hexeguitar/AudioSignalGenerator/firmware/src/symbols_bmp.c

/* ### Audio Test Signal Generator #############################################
 * Copyright (c) 2017, Piotr Zapart, www.hexeguitar.com
 *
 * Caution!!!
 * Program uses modified libraries:
 * - Teensy Audio library by Paul Stoffregen
 *          - data_waveforms.c : added exponential look-up table
 *          - synth_tonesweep :
 *                              1. exponential frequency sweep
 *                              2. added sweep pause option
 *                              3. added sweep direction control
 *                              4. added sweep stop option
 *          - synth_waveform:   fixed a small bug, pulse waveform was generated
 *                              at half of the set frequency
 * - SD.h : Teensy optimization turned on
 * - Adafruit_SSD1306_t3.h - uses i2c_t3 lib in DMA mode instad of stock Wire.h
 *
 * Modified libraries are provide in the /lib directory.
 *
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
 * THE SOFTWARE IS PROVIDED "AS IS", WITHOUT WARRANTY OF ANY KIND, EXPRESS OR
 * IMPLIED, INCLUDING BUT NOT LIMITED TO THE WARRANTIES OF MERCHANTABILITY,
 * FITNESS FOR A PARTICULAR PURPOSE AND NONINFRINGEMENT. IN NO EVENT SHALL THE
 * AUTHORS OR COPYRIGHT HOLDERS BE LIABLE FOR ANY CLAIM, DAMAGES OR OTHER
 * LIABILITY, WHETHER IN AN ACTION OF CONTRACT, TORT OR OTHERWISE, ARISING FROM,
 * OUT OF OR IN CONNECTION WITH THE SOFTWARE OR THE USE OR OTHER DEALINGS IN
 * THE SOFTWARE.
 */

#include <stdint.h>

const uint8_t waveSymbols [] = {
	// 'SIN_symbol16x8'
	0x3c, 0x00, 0x42, 0x00, 0x81, 0x00, 0x81, 0x01, 0x80, 0x81, 0x00, 0x81, 0x00, 0x42, 0x00, 0x3c,

    // 'TRI_symbol16x8'
	0x08, 0x00, 0x14, 0x00, 0x22, 0x00, 0x41, 0x01, 0x80, 0x82, 0x00, 0x44, 0x00, 0x28, 0x00, 0x10,

    // 'SQR_symbol16x8'
	0xff, 0x00, 0x81, 0x00, 0x81, 0x00, 0x81, 0x02, 0x81, 0x02, 0x01, 0x02, 0x01, 0x02, 0x01, 0xfe,

    // 'PULSE_symbol16x8'
	0xf5, 0x01, 0x90, 0x01, 0x91, 0x01, 0x90, 0x01, 0x91, 0x01, 0x90, 0x01, 0x91, 0x01, 0x9f, 0xff,

	// 'R_DN_symbol16x8'
	0xc0, 0x00, 0xb0, 0x00, 0x8c, 0x00, 0x83, 0x00, 0x80, 0xc0, 0x80, 0x30, 0x80, 0x0c, 0x80, 0x03,

	// 'R_UP_symbol16x8'
	0x00, 0x03, 0x00, 0x0d, 0x00, 0x31, 0x00, 0xc1, 0x03, 0x01, 0x0c, 0x01, 0x30, 0x01, 0xc0, 0x01,
};

const uint8_t welcomeScrn [] = {
	// 'WelcomeScrn'
	0xff, 0xff, 0xff, 0xff, 0xff, 0xff, 0xff, 0xff, 0xff, 0xff, 0xff, 0xff, 0xff, 0xff, 0xff, 0xff,
	0xe0, 0x00, 0x00, 0x00, 0x00, 0x00, 0x00, 0x00, 0x00, 0x00, 0x00, 0x00, 0x00, 0x00, 0x00, 0x07,
	0xc0, 0x00, 0x00, 0x00, 0x00, 0x00, 0x00, 0x00, 0x00, 0x00, 0x00, 0x00, 0x00, 0x00, 0x00, 0x03,
	0x80, 0x00, 0x00, 0x00, 0x00, 0x00, 0x00, 0x00, 0x00, 0x00, 0x00, 0x00, 0x00, 0x00, 0x00, 0x01,
	0x80, 0x00, 0x00, 0x00, 0x00, 0x00, 0x00, 0x00, 0x00, 0x00, 0x00, 0x00, 0x00, 0x00, 0x00, 0x01,
	0x80, 0x03, 0x83, 0x06, 0x3f, 0x86, 0x0f, 0xc0, 0x1e, 0x30, 0x7e, 0x1c, 0x30, 0xe0, 0x60, 0x01,
	0x80, 0x03, 0x83, 0x06, 0x3f, 0xc6, 0x1f, 0xe0, 0x3f, 0x30, 0xff, 0x1e, 0x30, 0xe0, 0x60, 0x01,
	0x80, 0x06, 0xc3, 0x06, 0x30, 0xe6, 0x38, 0x70, 0x31, 0x31, 0xc1, 0x1e, 0x31, 0xb0, 0x60, 0x01,
	0x80, 0x06, 0xc3, 0x06, 0x30, 0x66, 0x30, 0x30, 0x30, 0x31, 0x80, 0x1b, 0x31, 0xb0, 0x60, 0x01,
	0x80, 0x06, 0xc3, 0x06, 0x30, 0x66, 0x30, 0x30, 0x38, 0x31, 0x80, 0x1b, 0x31, 0xb0, 0x60, 0x01,
	0x80, 0x0c, 0x63, 0x06, 0x30, 0x66, 0x30, 0x30, 0x1e, 0x31, 0x9f, 0x19, 0x33, 0x18, 0x60, 0x01,
	0x80, 0x0f, 0xe3, 0x06, 0x30, 0x66, 0x30, 0x30, 0x07, 0x31, 0x9f, 0x19, 0xb3, 0xf8, 0x60, 0x01,
	0x80, 0x0f, 0xe3, 0x06, 0x30, 0x66, 0x30, 0x30, 0x03, 0x31, 0x83, 0x19, 0xb3, 0xf8, 0x60, 0x01,
	0x80, 0x18, 0x33, 0x8e, 0x30, 0xe6, 0x38, 0x70, 0x23, 0x31, 0xc3, 0x18, 0xf6, 0x0c, 0x60, 0x01,
	0x80, 0x18, 0x31, 0xfc, 0x3f, 0xc6, 0x1f, 0xe0, 0x3f, 0x30, 0xff, 0x18, 0xf6, 0x0c, 0x7e, 0x01,
	0x80, 0x18, 0x30, 0xf8, 0x3f, 0x86, 0x0f, 0xc0, 0x1e, 0x30, 0x7e, 0x18, 0x76, 0x0c, 0x7e, 0x01,
	0x80, 0x00, 0x00, 0x00, 0x00, 0x00, 0x00, 0x00, 0x00, 0x00, 0x00, 0x00, 0x00, 0x00, 0x00, 0x01,
	0x80, 0x00, 0x00, 0x00, 0x00, 0x00, 0x00, 0x00, 0x00, 0x00, 0x00, 0x00, 0x00, 0x00, 0x00, 0x01,
	0x80, 0x00, 0x00, 0x00, 0x00, 0x00, 0x00, 0x00, 0x00, 0x00, 0x00, 0x00, 0x00, 0x00, 0x00, 0x01,
	0x80, 0x00, 0x00, 0x00, 0x00, 0x00, 0x00, 0x00, 0x00, 0x00, 0x00, 0x00, 0x00, 0x00, 0x00, 0x01,
	0x80, 0x00, 0x03, 0xf1, 0xfc, 0xe1, 0x8f, 0xe7, 0xe0, 0x71, 0xfe, 0x1f, 0x8f, 0xc0, 0x00, 0x01,
	0x80, 0x00, 0x07, 0xf9, 0xfc, 0xf1, 0x8f, 0xe7, 0xf0, 0x71, 0xfe, 0x3f, 0xcf, 0xe0, 0x00, 0x01,
	0x80, 0x00, 0x0e, 0x09, 0x80, 0xf1, 0x8c, 0x06, 0x30, 0xd8, 0x30, 0x70, 0xec, 0x60, 0x00, 0x01,
	0x80, 0x00, 0x0c, 0x01, 0x80, 0xd9, 0x8c, 0x06, 0x30, 0xd8, 0x30, 0x60, 0x6c, 0x60, 0x00, 0x01,
	0x80, 0x00, 0x0c, 0x01, 0xf8, 0xd9, 0x8f, 0xc6, 0x30, 0xd8, 0x30, 0x60, 0x6c, 0x60, 0x00, 0x01,
	0x80, 0x00, 0x0c, 0xf9, 0xf8, 0xc9, 0x8f, 0xc7, 0xe1, 0x8c, 0x30, 0x60, 0x6f, 0xc0, 0x00, 0x01,
	0x80, 0x00, 0x0c, 0xf9, 0x80, 0xcd, 0x8c, 0x07, 0xe1, 0xfc, 0x30, 0x60, 0x6f, 0xc0, 0x00, 0x01,
	0x80, 0x00, 0x0c, 0x19, 0x80, 0xcd, 0x8c, 0x06, 0x31, 0xfc, 0x30, 0x60, 0x6c, 0x60, 0x00, 0x01,
	0x80, 0x00, 0x0e, 0x19, 0x80, 0xc7, 0x8c, 0x06, 0x33, 0x06, 0x30, 0x70, 0xec, 0x60, 0x00, 0x01,
	0x80, 0x00, 0x07, 0xf9, 0xfc, 0xc7, 0x8f, 0xe6, 0x1b, 0x06, 0x30, 0x3f, 0xcc, 0x30, 0x00, 0x01,
	0x80, 0x00, 0x03, 0xf1, 0xfc, 0xc3, 0x8f, 0xe6, 0x1b, 0x06, 0x30, 0x1f, 0x8c, 0x30, 0x00, 0x01,
	0x80, 0x00, 0x00, 0x00, 0x00, 0x00, 0x00, 0x00, 0x00, 0x00, 0x00, 0x00, 0x00, 0x00, 0x00, 0x01,
	0x80, 0x00, 0x00, 0x00, 0x00, 0x00, 0x00, 0x00, 0x00, 0x00, 0x00, 0x00, 0x00, 0x00, 0x00, 0x01,
	0x80, 0x00, 0x00, 0x00, 0x00, 0x00, 0x00, 0x00, 0x00, 0x00, 0x00, 0x00, 0x00, 0x00, 0x00, 0x01,
	0x80, 0x00, 0x00, 0x00, 0x00, 0x00, 0x00, 0x00, 0x00, 0x00, 0x00, 0x00, 0x00, 0x00, 0x00, 0x01,
	0x80, 0x00, 0x00, 0x00, 0x00, 0x00, 0x00, 0x00, 0x00, 0x00, 0x00, 0x00, 0x00, 0x00, 0x00, 0x01,
	0x80, 0x00, 0x00, 0x00, 0x00, 0x00, 0x00, 0x00, 0x00, 0x00, 0x00, 0x00, 0x00, 0x00, 0x00, 0x01,
	0x80, 0x20, 0x00, 0x01, 0xe0, 0x07, 0xc2, 0x1e, 0x08, 0x79, 0xf8, 0x01, 0xc1, 0x02, 0x1f, 0x01,
	0x80, 0x20, 0x00, 0x01, 0x10, 0x00, 0x42, 0x11, 0x08, 0x44, 0x20, 0x02, 0x22, 0x8e, 0x01, 0x01,
	0x80, 0x28, 0x00, 0x01, 0x10, 0x00, 0x86, 0x11, 0x18, 0x44, 0x20, 0x00, 0x24, 0x42, 0x02, 0x01,
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
};
