hexeguitar/AudioSignalGenerator/(commit log)

2017-07-09 BOM update
2017-07-17 Documentation updated
    small code cleanup and fixes
    [main.cpp, symbols_bmp.c]
